Leonardo-Da-Pinchy/Robot-Arm/robot_software/src/pinchy_description/cad/EE_STEP_V1/J6_Hub.step

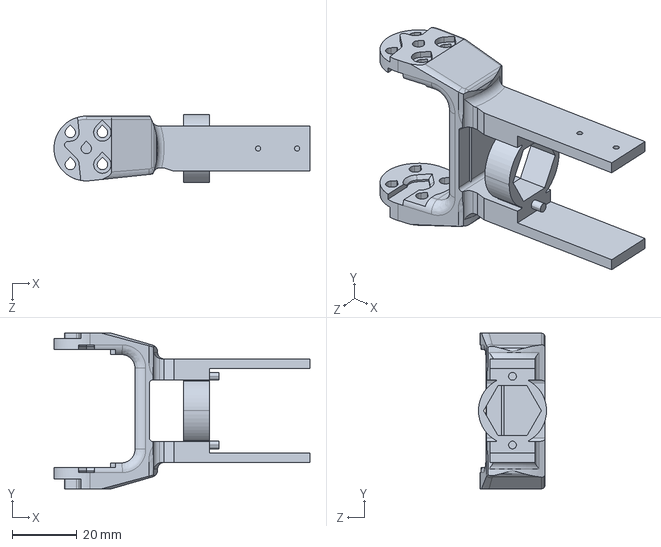
[picture p1: CAD file, 2026-11-09]
robot_software/src/pinchy_description/cad/EE_STEP_V1/J6_Hub.step
79.0 x 48.0 x 21.0 mm
