Leonardo-Da-Pinchy/Robot-Arm/robot_software/src/pinchy_description/meshes/cad4/wrist_roll_follower_so101_noclaw.stl

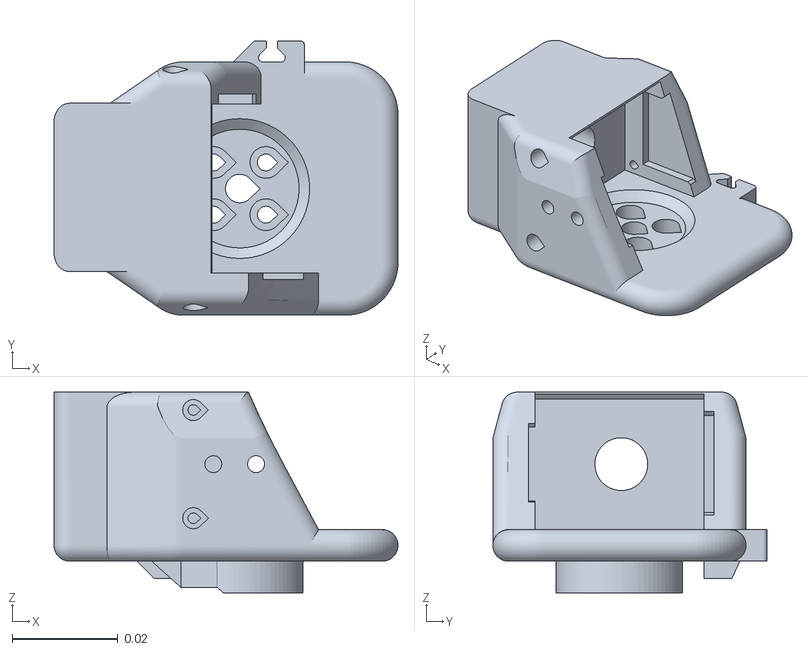
[picture p2: CAD file, 2026-11-09]
robot_software/src/pinchy_description/meshes/cad4/wrist_roll_follower_so101_noclaw.stl
0.0652 x 0.052 x 0.0381
