Leonardo-Da-Pinchy/Robot-Arm/robot_software/src/pinchy_description/meshes/ee_v1/J6_Sleeve.stl

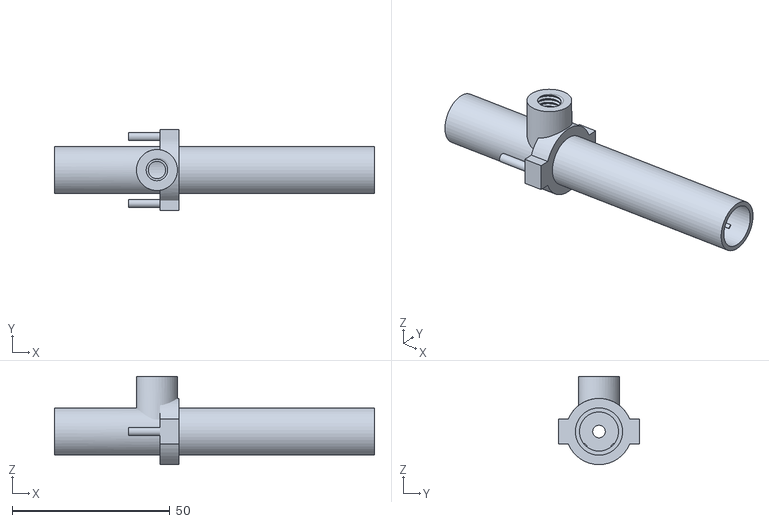
[picture p3: CAD file, 2026-11-09]
robot_software/src/pinchy_description/meshes/ee_v1/J6_Sleeve.stl
101.5 x 25.6 x 28.0
