Leonardo-Da-Pinchy/Robot-Arm/robot_software/src/pinchy_description/meshes/ee_v1/Wrist_Roll_Follower_SO101_NoClaw.stl

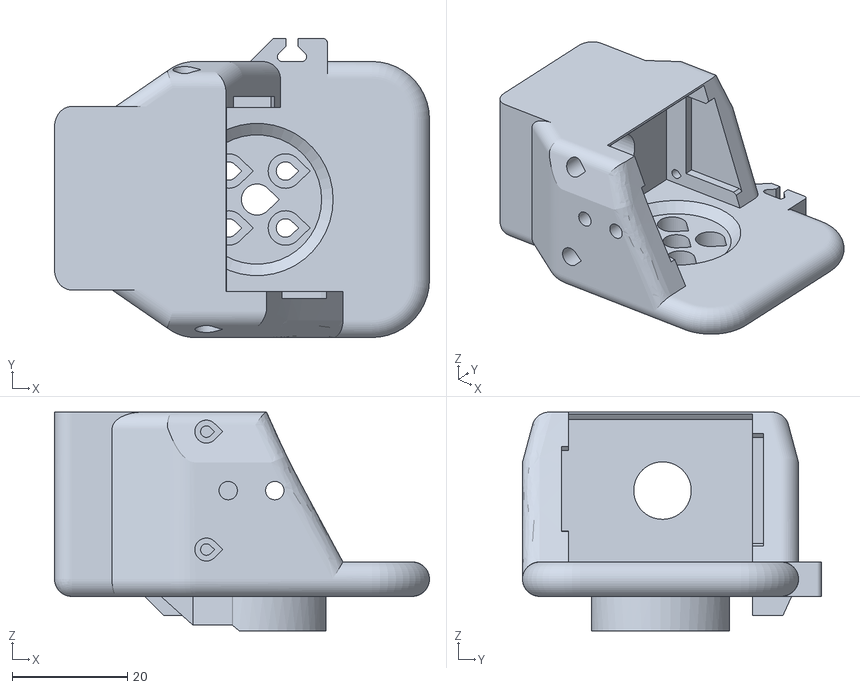
[picture p4: CAD file, 2026-11-09]
robot_software/src/pinchy_description/meshes/ee_v1/Wrist_Roll_Follower_SO101_NoClaw.stl
65.2 x 52.0 x 38.1
