Leonardo-Da-Pinchy/Robot-Arm/robot_software/src/pinchy_description/cad/EE_STEP_V1/J6_PreloadShims.step

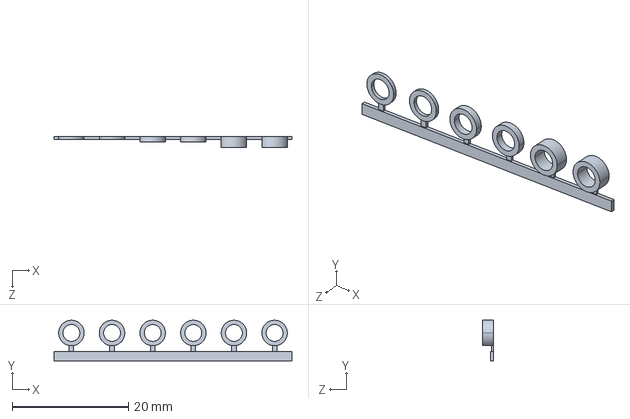
[picture p5: CAD file, 2026-11-09]
robot_software/src/pinchy_description/cad/EE_STEP_V1/J6_PreloadShims.step
41.0 x 7.00 x 1.96 mm
