Leonardo-Da-Pinchy/Robot-Arm/robot_software/src/pinchy_description/meshes/ee_v1/J6_FrontCap.stl

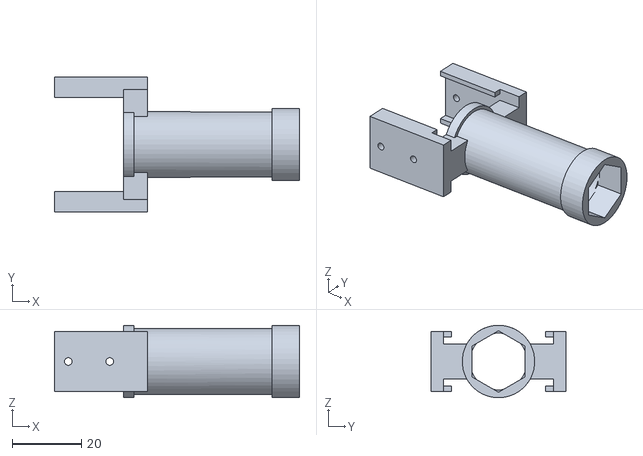
[picture p6: CAD file, 2026-11-09]
robot_software/src/pinchy_description/meshes/ee_v1/J6_FrontCap.stl
71.0 x 39.0 x 21.0
