Leonardo-Da-Pinchy/Robot-Arm/robot_software/src/pinchy_description/cad/EE_STEP_V1/J6_Thumbscrew.step

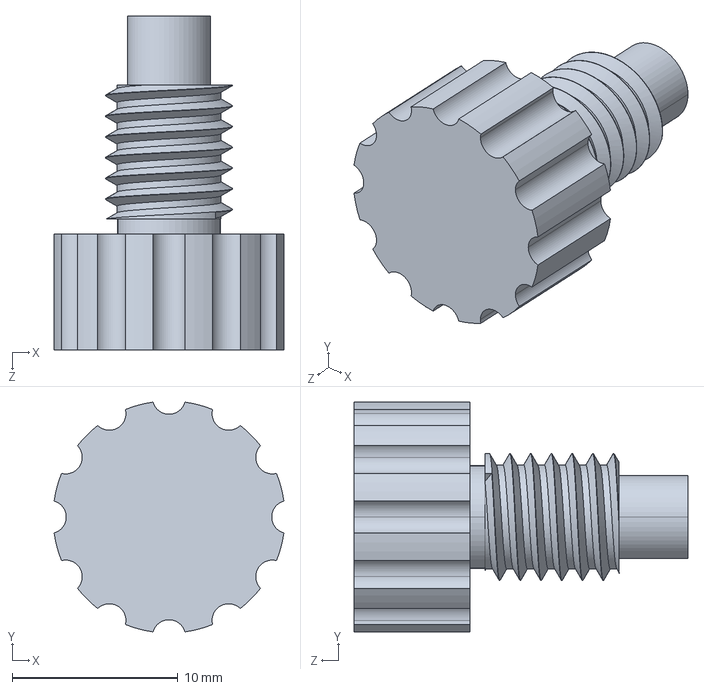
[picture p7: CAD file, 2026-11-09]
robot_software/src/pinchy_description/cad/EE_STEP_V1/J6_Thumbscrew.step
13.9 x 13.9 x 20.1 mm
