Leonardo-Da-Pinchy/Robot-Arm/(list of files, cad)

Other CAD files:
robot_software/src/pinchy_description/cad/EE_STEP_V1/J6_Sleeve.step
robot_software/src/pinchy_description/meshes/ee_v1/J6_Hub.stl
robot_software/src/pinchy_description/cad/EE_STEP_V1/Wrist_Roll_Follower_SO101_NoClaw.step
robot_software/src/pinchy_description/meshes/ee_v1/J6_PreloadShims.stl
robot_software/src/pinchy_description/cad/EE_STEP_V1/J6_FrontCap.step
robot_software/src/pinchy_description/meshes/ee_v1/J6_Thumbscrew.stl
