Leonardo-Da-Pinchy/Robot-Arm/robot_software/docs/validation/2026-11-08-control/build.txt

Starting >>> pinchy_description
Starting >>> pinchy_hardware
Finished <<< pinchy_description [0.22s]
--- stderr: pinchy_hardware
/home/leo/Robot-Arm/robot_software/src/pinchy_hardware/src/feetech_system.cpp: In member function ‘virtual hardware_interface::CallbackReturn pinchy_hardware::FeetechSystem::on_init(const hardware_interface::HardwareInfo&)’:
/home/leo/Robot-Arm/robot_software/src/pinchy_hardware/src/feetech_system.cpp:151:31: warning: ‘virtual rclcpp_lifecycle::node_interfaces::LifecycleNodeInterface::CallbackReturn hardware_interface::HardwareComponentInterface::on_init(const hardware_interface::HardwareInfo&)’ is deprecated: Use on_init(const HardwareComponentInterfaceParams & params) instead. [-Wdeprecated-declarations]
  151 |   if (SystemInterface::on_init(info) != CallbackReturn::SUCCESS) return CallbackReturn::ERROR;
      |       ~~~~~~~~~~~~~~~~~~~~~~~~^~~~~~
In file included from /opt/ros/jazzy/include/hardware_interface/hardware_interface/system_interface.hpp:18,
                 from /home/leo/Robot-Arm/robot_software/src/pinchy_hardware/include/pinchy_hardware/feetech_system.hpp:7,
                 from /home/leo/Robot-Arm/robot_software/src/pinchy_hardware/src/feetech_system.cpp:1:
/opt/ros/jazzy/include/hardware_interface/hardware_interface/hardware_component_interface.hpp:140:26: note: declared here
  140 |   virtual CallbackReturn on_init(const HardwareInfo & hardware_info);
      |                          ^~~~~~~
---
Finished <<< pinchy_hardware [10.7s]
Starting >>> pinchy_bringup
Finished <<< pinchy_bringup [0.33s]

Summary: 3 packages finished [11.5s]
  1 package had stderr output: pinchy_hardware
