Leonardo-Da-Pinchy/Robot-Arm/robot_software/src/pinchy_description/urdf/pinchy_arm.urdf

<?xml version="1.0"?>
<!-- Generated by tools/build_arm_model.py from supplied CAD 4 URDF and MJCF.
     Pen tip assumes nominal 5 mm sleeve compression. Velocity 30 deg/s is a
     software setting; effort 0 remains unspecified. Geometry alone does not
     provide collision avoidance. tool0 remains the sixth-axis origin.
     pointer_tip is the active RViz endpoint proxy; physical tip is unverified. -->
<robot name="pinchy_arm">
  <link name="base_link">
    <inertial>
      <origin xyz="0.0137179 -5.19711e-05 0.0334843" rpy="0 -0 0" />
      <mass value="0.147" />
      <inertia ixx="0.000114686" iyy="0.000136117" izz="0.000130364" ixy="-4.59787e-07" ixz="4.97151e-06" iyz="9.75275e-08" />
    </inertial>
    <visual name="base_link_base_motor_holder_so101_v1_visual">
      <origin xyz="-0.00636471 -9.94414e-05 -0.0024" rpy="1.5707963267949 -0 1.5707963267949" />
      <geometry>
        <mesh filename="package://pinchy_description/meshes/base_motor_holder_so101_v1.stl" scale="1 1 1" />
      </geometry>
      <material name="base_link_base_motor_holder_so101_v1_visual_color">
        <color rgba="1 0.82 0.12 1" />
      </material>
    </visual>
    <collision name="base_link_base_motor_holder_so101_v1_collision">
      <origin xyz="-0.00636471 -9.94414e-05 -0.0024" rpy="1.5707963267949 -0 1.5707963267949" />
      <geometry>
        <mesh filename="package://pinchy_description/meshes/base_motor_holder_so101_v1.stl" scale="1 1 1" />
      </geometry>
    </collision>
    <visual name="base_link_base_so101_v2_visual">
      <origin xyz="-0.00636471 -8.97657e-09 -0.0024" rpy="1.5707963267949 -0 1.5707963267949" />
      <geometry>
        <mesh filename="package://pinchy_description/meshes/base_so101_v2.stl" scale="1 1 1" />
      </geometry>
      <material name="base_link_base_so101_v2_visual_color">
        <color rgba="1 0.82 0.12 1" />
      </material>
    </visual>
    <collision name="base_link_base_so101_v2_collision">
      <origin xyz="-0.00636471 -8.97657e-09 -0.0024" rpy="1.5707963267949 -0 1.5707963267949" />
      <geometry>
        <mesh filename="package://pinchy_description/meshes/base_so101_v2.stl" scale="1 1 1" />
      </geometry>
    </collision>
    <visual name="base_link_sts3215_03a_v1_visual">
      <origin xyz="0.0263353 -8.97657e-09 0.0437" rpy="-5.71022e-16 -1.928866e-16 1.225816e-15" />
      <geometry>
        <mesh filename="package://pinchy_description/meshes/sts3215_03a_v1.stl" scale="1 1 1" />
      </geometry>
      <material name="base_link_sts3215_03a_v1_visual_color">
        <color rgba="0.1 0.1 0.1 1" />
      </material>
    </visual>
    <collision name="base_link_sts3215_03a_v1_collision">
      <origin xyz="0.0263353 -8.97657e-09 0.0437" rpy="-5.71022e-16 -1.928866e-16 1.225816e-15" />
      <geometry>
        <mesh filename="package://pinchy_description/meshes/sts3215_03a_v1.stl" scale="1 1 1" />
      </geometry>
    </collision>
    <visual name="base_link_waveshare_mounting_plate_so101_v2_visual">
      <origin xyz="-0.0309827 -0.000199441 0.0474" rpy="1.5707963267949 -0 1.5707963267949" />
      <geometry>
        <mesh filename="package://pinchy_description/meshes/waveshare_mounting_plate_so101_v2.stl" scale="1 1 1" />
      </geometry>
      <material name="base_link_waveshare_mounting_plate_so101_v2_visual_color">
        <color rgba="1 0.82 0.12 1" />
      </material>
    </visual>
    <collision name="base_link_waveshare_mounting_plate_so101_v2_collision">
      <origin xyz="-0.0309827 -0.000199441 0.0474" rpy="1.5707963267949 -0 1.5707963267949" />
      <geometry>
        <mesh filename="package://pinchy_description/meshes/waveshare_mounting_plate_so101_v2.stl" scale="1 1 1" />
      </geometry>
    </collision>
  </link>
  <link name="shoulder_link">
    <inertial>
      <origin xyz="-0.0307604 -1.66727e-05 -0.0252713" rpy="0 -0 0" />
      <mass value="0.100006" />
      <inertia ixx="8.3759e-05" iyy="8.10403e-05" izz="2.39783e-05" ixy="7.55525e-08" ixz="-1.16342e-06" iyz="1.54663e-07" />
    </inertial>
    <visual name="shoulder_link_sts3215_03a_v1_visual">
      <origin xyz="-0.0303992 0.000422241 -0.0417" rpy="1.5707963267949 1.5707963267949 0" />
      <geometry>
        <mesh filename="package://pinchy_description/meshes/sts3215_03a_v1.stl" scale="1 1 1" />
      </geometry>
      <material name="shoulder_link_sts3215_03a_v1_visual_color">
        <color rgba="0.1 0.1 0.1 1" />
      </material>
    </visual>
    <collision name="shoulder_link_sts3215_03a_v1_collision">
      <origin xyz="-0.0303992 0.000422241 -0.0417" rpy="1.5707963267949 1.5707963267949 0" />
      <geometry>
        <mesh filename="package://pinchy_description/meshes/sts3215_03a_v1.stl" scale="1 1 1" />
      </geometry>
    </collision>
    <visual name="shoulder_link_motor_holder_so101_base_v1_visual">
      <origin xyz="-0.0675992 -0.000177759 0.0158499" rpy="1.5707963267949 -1.5707963267949 0" />
      <geometry>
        <mesh filename="package://pinchy_description/meshes/motor_holder_so101_base_v1.stl" scale="1 1 1" />
      </geometry>
      <material name="shoulder_link_motor_holder_so101_base_v1_visual_color">
        <color rgba="1 0.82 0.12 1" />
      </material>
    </visual>
    <collision name="shoulder_link_motor_holder_so101_base_v1_collision">
      <origin xyz="-0.0675992 -0.000177759 0.0158499" rpy="1.5707963267949 -1.5707963267949 0" />
      <geometry>
        <mesh filename="package://pinchy_description/meshes/motor_holder_so101_base_v1.stl" scale="1 1 1" />
      </geometry>
    </collision>
    <visual name="shoulder_link_rotation_pitch_so101_v1_visual">
      <origin xyz="0.0122008 2.22413e-05 0.0464" rpy="-1.5707963267949 1.17610206093279e-33 1.17610206093279e-33" />
      <geometry>
        <mesh filename="package://pinchy_description/meshes/rotation_pitch_so101_v1.stl" scale="1 1 1" />
      </geometry>
      <material name="shoulder_link_rotation_pitch_so101_v1_visual_color">
        <color rgba="1 0.82 0.12 1" />
      </material>
    </visual>
    <collision name="shoulder_link_rotation_pitch_so101_v1_collision">
      <origin xyz="0.0122008 2.22413e-05 0.0464" rpy="-1.5707963267949 1.17610206093279e-33 1.17610206093279e-33" />
      <geometry>
        <mesh filename="package://pinchy_description/meshes/rotation_pitch_so101_v1.stl" scale="1 1 1" />
      </geometry>
    </collision>
  </link>
  <link name="upper_arm_link">
    <inertial>
      <origin xyz="-0.0898471 -0.00838224 0.0184089" rpy="0 -0 0" />
      <mass value="0.103" />
      <inertia ixx="4.08002e-05" iyy="0.000147318" izz="0.000142487" ixy="-1.97819e-05" ixz="-4.03016e-08" iyz="8.97326e-09" />
    </inertial>
    <visual name="upper_arm_link_sts3215_03a_v1_visual">
      <origin xyz="-0.11257 -0.0155 0.0187" rpy="-3.14159265358979 4.51027920809722e-16 -1.5707963267949" />
      <geometry>
        <mesh filename="package://pinchy_description/meshes/sts3215_03a_v1.stl" scale="1 1 1" />
      </geometry>
      <material name="upper_arm_link_sts3215_03a_v1_visual_color">
        <color rgba="0.1 0.1 0.1 1" />
      </material>
    </visual>
    <collision name="upper_arm_link_sts3215_03a_v1_collision">
      <origin xyz="-0.11257 -0.0155 0.0187" rpy="-3.14159265358979 4.51027920809722e-16 -1.5707963267949" />
      <geometry>
        <mesh filename="package://pinchy_description/meshes/sts3215_03a_v1.stl" scale="1 1 1" />
      </geometry>
    </collision>
    <visual name="upper_arm_link_upper_arm_so101_v1_visual">
      <origin xyz="-0.065085 0.012 0.0182" rpy="3.14159265358979 -0 0" />
      <geometry>
        <mesh filename="package://pinchy_description/meshes/upper_arm_so101_v1.stl" scale="1 1 1" />
      </geometry>
      <material name="upper_arm_link_upper_arm_so101_v1_visual_color">
        <color rgba="1 0.82 0.12 1" />
      </material>
    </visual>
    <collision name="upper_arm_link_upper_arm_so101_v1_collision">
      <origin xyz="-0.065085 0.012 0.0182" rpy="3.14159265358979 -0 0" />
      <geometry>
        <mesh filename="package://pinchy_description/meshes/upper_arm_so101_v1.stl" scale="1 1 1" />
      </geometry>
    </collision>
  </link>
  <link name="forearm_link">
    <inertial>
      <origin xyz="-0.0980701 0.00324376 0.0182831" rpy="0 -0 0" />
      <mass value="0.104" />
      <inertia ixx="2.87438e-05" iyy="0.000159844" izz="0.00014529" ixy="7.41152e-06" ixz="1.26409e-06" iyz="-4.90188e-08" />
    </inertial>
    <visual name="forearm_link_under_arm_so101_v1_visual">
      <origin xyz="-0.0648499 -0.032 0.0182" rpy="3.14159265358979 -0 0" />
      <geometry>
        <mesh filename="package://pinchy_description/meshes/under_arm_so101_v1.stl" scale="1 1 1" />
      </geometry>
      <material name="forearm_link_under_arm_so101_v1_visual_color">
        <color rgba="1 0.82 0.12 1" />
      </material>
    </visual>
    <collision name="forearm_link_under_arm_so101_v1_collision">
      <origin xyz="-0.0648499 -0.032 0.0182" rpy="3.14159265358979 -0 0" />
      <geometry>
        <mesh filename="package://pinchy_description/meshes/under_arm_so101_v1.stl" scale="1 1 1" />
      </geometry>
    </collision>
    <visual name="forearm_link_motor_holder_so101_wrist_v1_visual">
      <origin xyz="-0.0648499 -0.032 0.018" rpy="-3.14159265358979 -1.276756e-15 3.8372e-15" />
      <geometry>
        <mesh filename="package://pinchy_description/meshes/motor_holder_so101_wrist_v1.stl" scale="1 1 1" />
      </geometry>
      <material name="forearm_link_motor_holder_so101_wrist_v1_visual_color">
        <color rgba="1 0.82 0.12 1" />
      </material>
    </visual>
    <collision name="forearm_link_motor_holder_so101_wrist_v1_collision">
      <origin xyz="-0.0648499 -0.032 0.018" rpy="-3.14159265358979 -1.276756e-15 3.8372e-15" />
      <geometry>
        <mesh filename="package://pinchy_description/meshes/motor_holder_so101_wrist_v1.stl" scale="1 1 1" />
      </geometry>
    </collision>
    <visual name="forearm_link_sts3215_03a_v1_visual">
      <origin xyz="-0.1224 0.0052 0.0187" rpy="-3.14159265358979 1.44329e-15 3.14159265358979" />
      <geometry>
        <mesh filename="package://pinchy_description/meshes/sts3215_03a_v1.stl" scale="1 1 1" />
      </geometry>
      <material name="forearm_link_sts3215_03a_v1_visual_color">
        <color rgba="0.1 0.1 0.1 1" />
      </material>
    </visual>
    <collision name="forearm_link_sts3215_03a_v1_collision">
      <origin xyz="-0.1224 0.0052 0.0187" rpy="-3.14159265358979 1.44329e-15 3.14159265358979" />
      <geometry>
        <mesh filename="package://pinchy_description/meshes/sts3215_03a_v1.stl" scale="1 1 1" />
      </geometry>
    </collision>
  </link>
  <link name="wrist_pitch_link">
    <inertial>
      <origin xyz="-0.000103312 -0.0386143 0.0281156" rpy="0 -0 0" />
      <mass value="0.079" />
      <inertia ixx="3.68263e-05" iyy="2.5391e-05" izz="2.1e-05" ixy="1.7893e-08" ixz="-5.28128e-08" iyz="3.6412e-06" />
    </inertial>
    <visual name="wrist_pitch_link_sts3215_03a_no_horn_v1_visual">
      <origin xyz="8.32667e-17 -0.0424 0.0306" rpy="1.5707963267949 1.5707963267949 0" />
      <geometry>
        <mesh filename="package://pinchy_description/meshes/sts3215_03a_no_horn_v1.stl" scale="1 1 1" />
      </geometry>
      <material name="wrist_pitch_link_sts3215_03a_no_horn_v1_visual_color">
        <color rgba="0.1 0.1 0.1 1.0" />
      </material>
    </visual>
    <collision name="wrist_pitch_link_sts3215_03a_no_horn_v1_collision">
      <origin xyz="8.32667e-17 -0.0424 0.0306" rpy="1.5707963267949 1.5707963267949 0" />
      <geometry>
        <mesh filename="package://pinchy_description/meshes/sts3215_03a_no_horn_v1.stl" scale="1 1 1" />
      </geometry>
    </collision>
    <visual name="wrist_pitch_link_wrist_roll_pitch_so101_v2_visual">
      <origin xyz="0 -0.028 0.0181" rpy="-1.5707963267949 -1.5707963267949 0" />
      <geometry>
        <mesh filename="package://pinchy_description/meshes/wrist_roll_pitch_so101_v2.stl" scale="1 1 1" />
      </geometry>
      <material name="wrist_pitch_link_wrist_roll_pitch_so101_v2_visual_color">
        <color rgba="1 0.82 0.12 1" />
      </material>
    </visual>
    <collision name="wrist_pitch_link_wrist_roll_pitch_so101_v2_collision">
      <origin xyz="0 -0.028 0.0181" rpy="-1.5707963267949 -1.5707963267949 0" />
      <geometry>
        <mesh filename="package://pinchy_description/meshes/wrist_roll_pitch_so101_v2.stl" scale="1 1 1" />
      </geometry>
    </collision>
  </link>
  <link name="wrist_roll_link">
    <inertial>
      <origin xyz="0.0007 0.00038 -0.02089" rpy="0 -0 0" />
      <mass value="0.079340" />
      <inertia ixx="1.56096e-05" iyy="2.67486e-05" izz="2.97125e-05" ixy="-1.824e-07" ixz="5.264e-07" iyz="1.18e-07" />
    </inertial>
    <visual name="wrist_roll_link_sts3215_03a_v1_visual">
      <origin xyz="0.0077 0.0001 -0.0234" rpy="-1.5707963267949 1.14708099339987e-14 6.77519809590345e-15" />
      <geometry>
        <mesh filename="package://pinchy_description/meshes/sts3215_03a_v1.stl" scale="1 1 1" />
      </geometry>
      <material name="wrist_roll_link_sts3215_03a_v1_visual_color">
        <color rgba="0.1 0.1 0.1 1" />
      </material>
    </visual>
    <collision name="wrist_roll_link_sts3215_03a_v1_collision">
      <origin xyz="0.0077 0.0001 -0.0234" rpy="-1.5707963267949 1.14708099339987e-14 6.77519809590345e-15" />
      <geometry>
        <mesh filename="package://pinchy_description/meshes/sts3215_03a_v1.stl" scale="1 1 1" />
      </geometry>
    </collision>
    <visual name="wrist_roll_link_wrist_roll_follower_so101_noclaw_visual">
      <origin xyz="8.32667e-17 -0.000218214 0.000949706" rpy="3.14159265358979 -0 0" />
      <geometry>
        <mesh filename="package://pinchy_description/meshes/cad4/wrist_roll_follower_so101_noclaw.stl" scale="1 1 1" />
      </geometry>
      <material name="wrist_roll_link_wrist_roll_follower_so101_noclaw_visual_color">
        <color rgba="1 0.82 0.12 1" />
      </material>
    </visual>
    <collision name="wrist_roll_link_wrist_roll_follower_so101_noclaw_collision">
      <origin xyz="8.32667e-17 -0.000218214 0.000949706" rpy="3.14159265358979 -0 0" />
      <geometry>
        <mesh filename="package://pinchy_description/meshes/cad4/wrist_roll_follower_so101_noclaw.stl" scale="1 1 1" />
      </geometry>
    </collision>
  </link>
  <link name="pen_holder_link">
    <inertial>
      <origin xyz="0.000662 -0.048212 0.018669" rpy="0 -0 0" />
      <mass value="0.052330" />
      <inertia ixx="8.04227e-05" iyy="9.9112e-06" izz="7.43524e-05" ixy="5.927e-07" ixz="-1.7e-09" iyz="3.874e-07" />
    </inertial>
    <visual name="pen_holder_link_yoke_cheek_drive_visual">
      <origin xyz="0 -0.008 -0.0015" rpy="0 -0 0" />
      <geometry>
        <box size="0.0196 0.025 0.003" />
      </geometry>
      <material name="pen_holder_link_yoke_cheek_drive_visual_color">
        <color rgba="0.2 0.55 0.95 1" />
      </material>
    </visual>
    <collision name="pen_holder_link_yoke_cheek_drive_collision">
      <origin xyz="0 -0.008 -0.0015" rpy="0 -0 0" />
      <geometry>
        <box size="0.0196 0.025 0.003" />
      </geometry>
    </collision>
    <visual name="pen_holder_link_yoke_cheek_idler_visual">
      <origin xyz="0 -0.008 0.0396" rpy="0 -0 0" />
      <geometry>
        <box size="0.0196 0.025 0.003" />
      </geometry>
      <material name="pen_holder_link_yoke_cheek_idler_visual_color">
        <color rgba="0.2 0.55 0.95 1" />
      </material>
    </visual>
    <collision name="pen_holder_link_yoke_cheek_idler_collision">
      <origin xyz="0 -0.008 0.0396" rpy="0 -0 0" />
      <geometry>
        <box size="0.0196 0.025 0.003" />
      </geometry>
    </collision>
    <visual name="pen_holder_link_yoke_bridge_visual">
      <origin xyz="0 -0.0315 0.01755" rpy="0 -0 0" />
      <geometry>
        <box size="0.0196 0.003 0.0441" />
      </geometry>
      <material name="pen_holder_link_yoke_bridge_visual_color">
        <color rgba="0.2 0.55 0.95 1" />
      </material>
    </visual>
    <collision name="pen_holder_link_yoke_bridge_collision">
      <origin xyz="0 -0.0315 0.01755" rpy="0 -0 0" />
      <geometry>
        <box size="0.0196 0.003 0.0441" />
      </geometry>
    </collision>
    <visual name="pen_holder_link_pen_sleeve_visual">
      <origin xyz="0 -0.075 0.0188" rpy="0 1.5707963267949 -1.5707963267949" />
      <geometry>
        <cylinder radius="0.0105" length="0.09" />
      </geometry>
      <material name="pen_holder_link_pen_sleeve_visual_color">
        <color rgba="0.2 0.55 0.95 0.35" />
      </material>
    </visual>
    <visual name="pen_holder_link_sharpie_visual">
      <origin xyz="0 -0.084 0.0188" rpy="0 1.5707963267949 -1.5707963267949" />
      <geometry>
        <cylinder radius="0.00575" length="0.11599999999999999" />
      </geometry>
      <material name="pen_holder_link_sharpie_visual_color">
        <color rgba="0.12 0.12 0.12 1" />
      </material>
    </visual>
    <visual name="pen_holder_link_sharpie_nib_visual">
      <origin xyz="0 -0.1455 0.0188" rpy="0 1.5707963267949 -1.5707963267949" />
      <geometry>
        <cylinder radius="0.0015" length="0.007000000000000006" />
      </geometry>
      <material name="pen_holder_link_sharpie_nib_visual_color">
        <color rgba="0.05 0.05 0.05 1" />
      </material>
    </visual>
    <collision name="pen_holder_link_pen_sleeve_col_collision">
      <origin xyz="0 -0.075 0.0188" rpy="0 1.5707963267949 -1.5707963267949" />
      <geometry>
        <cylinder radius="0.0105" length="0.09" />
      </geometry>
    </collision>
    <collision name="pen_holder_link_pen_sleeve_col_collision_start">
      <origin xyz="0 -0.03 0.0188" rpy="0 0 0" />
      <geometry>
        <sphere radius="0.0105" />
      </geometry>
    </collision>
    <collision name="pen_holder_link_pen_sleeve_col_collision_end">
      <origin xyz="0 -0.12 0.0188" rpy="0 0 0" />
      <geometry>
        <sphere radius="0.0105" />
      </geometry>
    </collision>
    <collision name="pen_holder_link_sharpie_col_collision">
      <origin xyz="0 -0.131 0.0188" rpy="0 1.5707963267949 -1.5707963267949" />
      <geometry>
        <cylinder radius="0.00575" length="0.021999999999999992" />
      </geometry>
    </collision>
    <collision name="pen_holder_link_sharpie_col_collision_start">
      <origin xyz="0 -0.12 0.0188" rpy="0 0 0" />
      <geometry>
        <sphere radius="0.00575" />
      </geometry>
    </collision>
    <collision name="pen_holder_link_sharpie_col_collision_end">
      <origin xyz="0 -0.142 0.0188" rpy="0 0 0" />
      <geometry>
        <sphere radius="0.00575" />
      </geometry>
    </collision>
  </link>
  <link name="pen_tip" />
  <joint name="shoulder_pan" type="revolute">
    <parent link="base_link" />
    <child link="shoulder_link" />
    <origin xyz="0.0388353 -8.97657e-09 0.0624" rpy="3.14159265358979 -6.66133814775094e-16 -3.14159265358979" />
    <axis xyz="0 0 1" />
    <limit lower="-1.91986217719376" upper="1.91986217719376" effort="0" velocity="0.5235987755982988" />
  </joint>
  <joint name="shoulder_lift" type="revolute">
    <parent link="shoulder_link" />
    <child link="upper_arm_link" />
    <origin xyz="-0.0303992 -0.0182778 -0.0542" rpy="-1.5707963267949 -1.5707963267949 0" />
    <axis xyz="0 0 1" />
    <limit lower="-1.74532925199432" upper="1.74532925199434" effort="0" velocity="0.5235987755982988" />
  </joint>
  <joint name="elbow_flex" type="revolute">
    <parent link="upper_arm_link" />
    <child link="forearm_link" />
    <origin xyz="-0.11257 -0.028 1.73763e-16" rpy="-1.11022302462516e-16 2.22044604925031e-16 1.5707963267949" />
    <axis xyz="0 0 1" />
    <limit lower="-1.69" upper="1.69" effort="0" velocity="0.5235987755982988" />
  </joint>
  <joint name="wrist_flex" type="revolute">
    <parent link="forearm_link" />
    <child link="wrist_pitch_link" />
    <origin xyz="-0.1349 0.0052 3.62355e-17" rpy="2.55351295663786e-15 2.22044604925031e-16 -1.5707963267949" />
    <axis xyz="0 0 1" />
    <limit lower="-1.65806284945569" upper="1.65806272933353" effort="0" velocity="0.5235987755982988" />
  </joint>
  <joint name="wrist_roll" type="revolute">
    <parent link="wrist_pitch_link" />
    <child link="wrist_roll_link" />
    <origin xyz="5.55112e-17 -0.0611 0.0181" rpy="1.5707963267949 0.048679514853462 3.14159265358979" />
    <axis xyz="0 0 1" />
    <limit lower="-2.74384729699925" upper="2.8412063093826" effort="0" velocity="0.5235987755982988" />
  </joint>
  <joint name="pen_pitch" type="revolute">
    <parent link="wrist_roll_link" />
    <child link="pen_holder_link" />
    <origin xyz="0.0202 0.0188 -0.0234" rpy="1.5707963267949 -5.24282746106053e-08 0" />
    <axis xyz="0 0 1" />
    <limit lower="-0.05236" upper="1.745329" effort="0" velocity="0.5235987755982988" />
  </joint>
  <joint name="pen_tip_fixed" type="fixed">
    <parent link="pen_holder_link" />
    <child link="pen_tip" />
    <origin xyz="0 -0.149 0.0188" rpy="1.5707963267949 0 0" />
  </joint>
  <link name="pointer_tip">
    <visual name="active_tcp_marker">
      <origin xyz="0 0 0" rpy="0 0 0" />
      <geometry>
        <sphere radius="0.002" />
      </geometry>
      <material name="active_tcp_marker_color">
        <color rgba="0 1 1 1" />
      </material>
    </visual>
  </link>
  <joint name="active_tcp_fixed" type="fixed">
    <parent link="pen_tip" />
    <child link="pointer_tip" />
    <origin xyz="0 0 0" rpy="0 0 0" />
  </joint>
  <link name="tool0" />
  <joint name="tool0_joint" type="fixed">
    <parent link="pen_holder_link" />
    <child link="tool0" />
    <origin xyz="0 0 0" rpy="0 0 0" />
  </joint>
</robot>
