Leonardo-Da-Pinchy/Robot-Arm/(commit log)

2026-11-01 Servo tools additions
2026-11-08 Add Feetech servo setup, chain tests, and diagnostics
2026-11-09 Joint movement of robot
    [J6_FrontCap.step, J6_FrontCap.stl, J6_Hub.step, J6_Hub.stl, J6_PreloadShims.step, J6_PreloadShims.stl, J6_Sleeve.step, J6_Sleeve.stl]
2026-11-14 Finished bringup + joint commands
    [arm_controllers.yaml, pinchy_arm.urdf]
